ambeloe/iov-rp2040/iov-rp2040_top.png

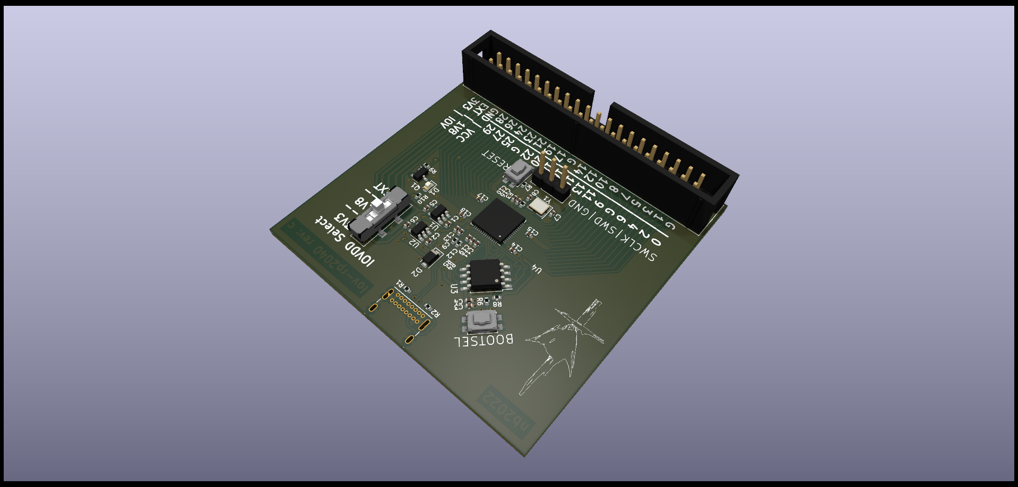
iov-rp2040_top.png
