ambeloe/iov-rp2040/README.md

# iov-rp2040
rp2040 dev board with selectable io voltages

iovdd range: 1.65v to 3.6v

PICO_FLASH_SPI_CLKDIV needs to be configured if running at 1.8V
generic boot2 needs to be used
