ambeloe/iov-rp2040/iov-rp2040.kicad_pcb

## KiCad design iov-rp2040.kicad_pcb (2022-09-12)

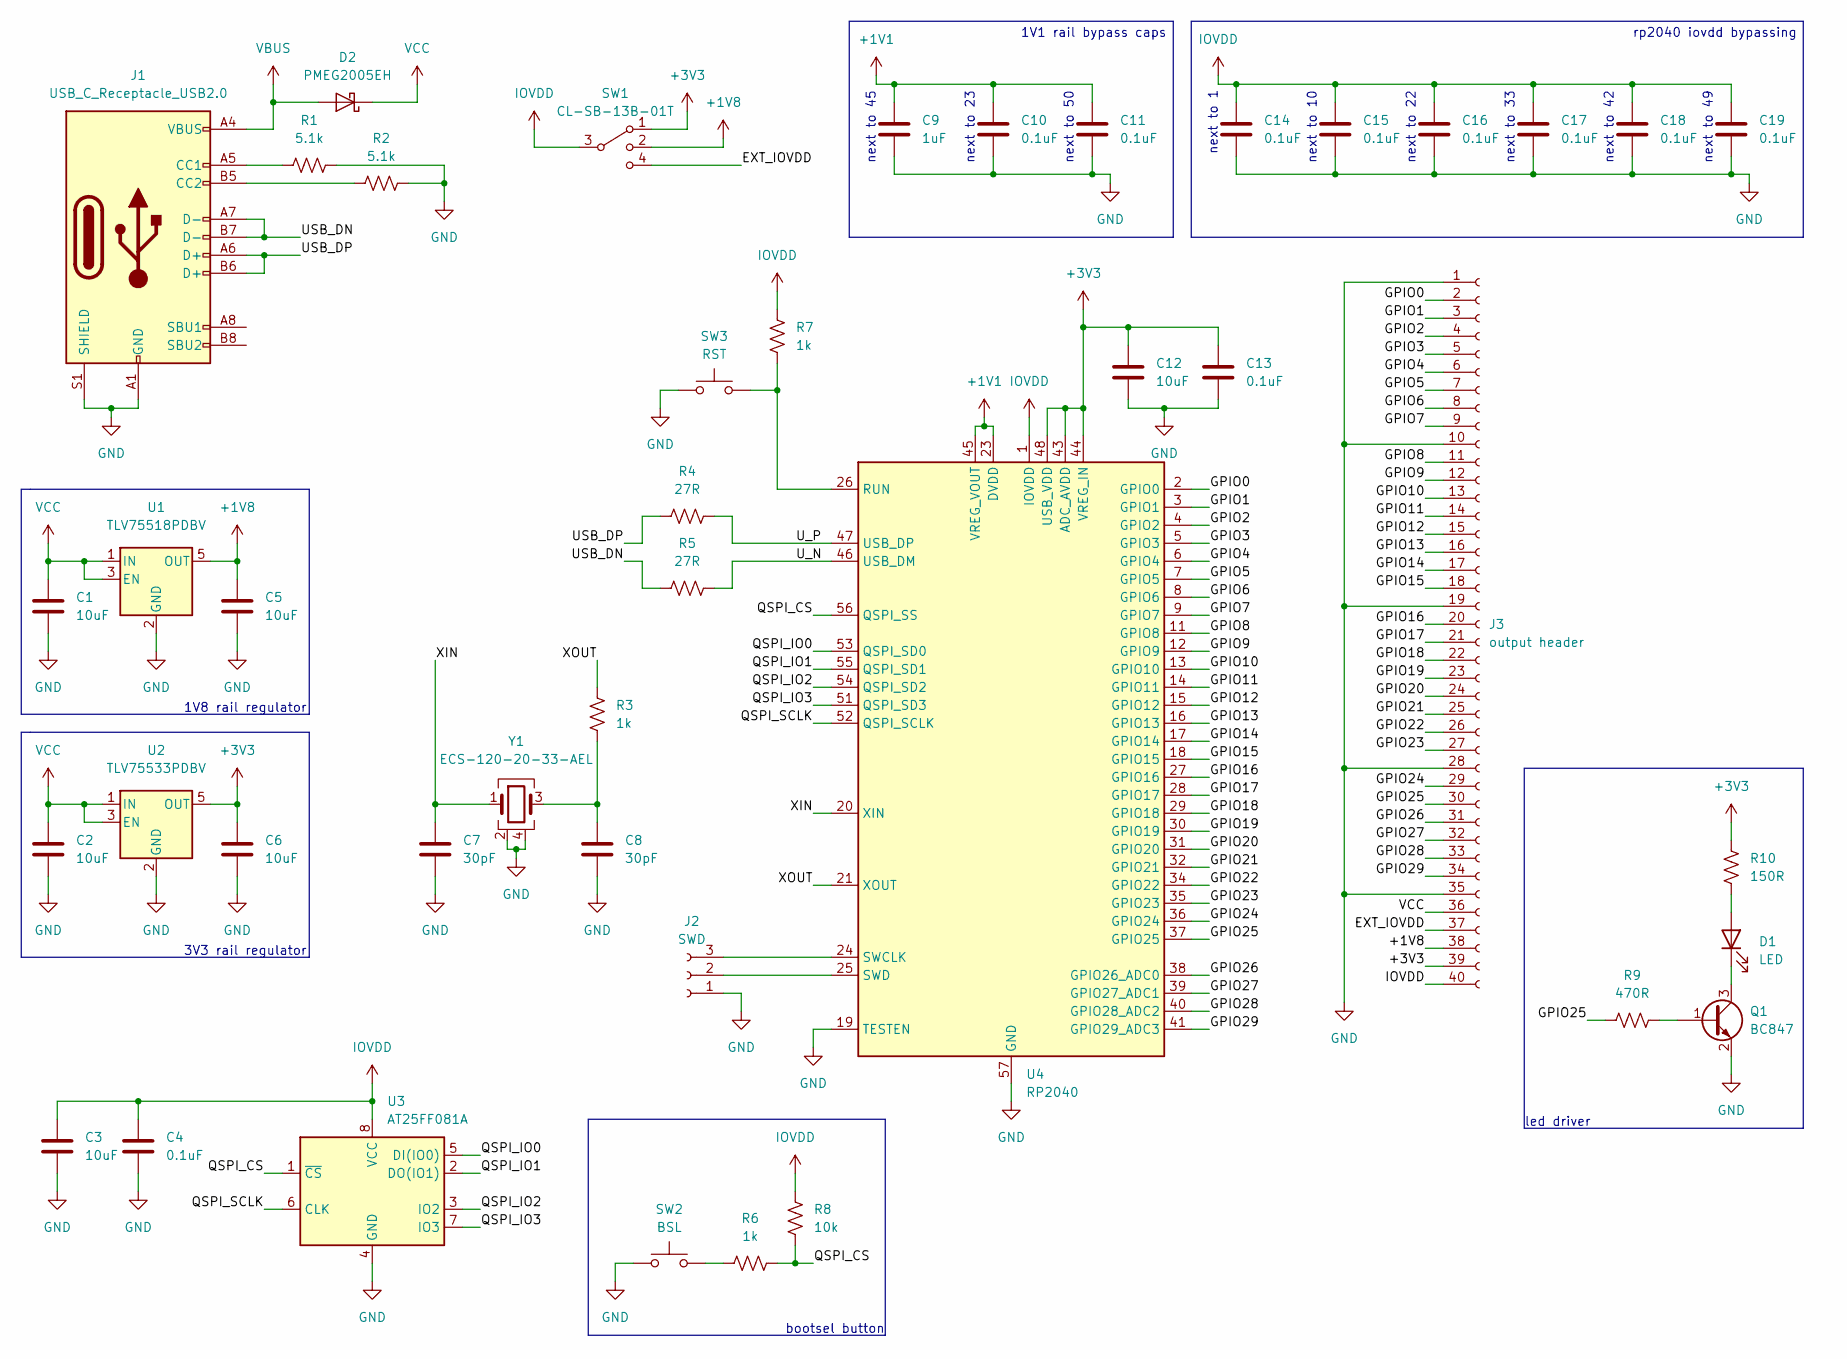
[picture p3: schematic iov-rp2040.kicad_sch]

Parts:
C1, C2, C3, C5, C6, C12: 10uF; C_0402_1005Metric_SmallRef
C4, C10, C11, C13, C14, C15, C16, C17, C18, C19: 0.1uF; C_0402_1005Metric_SmallRef
C7, C8: 30pF; C_0402_1005Metric_SmallRef
C9: 1uF; C_0402_1005Metric_SmallRef
D1: LED; LED_0603_1608Metric
D2: PMEG2005EH; D_SOD-123F
J1: USB_C_Receptacle_USB2.0; USB_C_Receptacle_GCT_USB4085
J2: SWD; PinHeader_1x03_P2.54mm_Vertical
J3: output header; IDC-Header_2x20_P2.54mm_Vertical
Q1: BC847; SOT-23
R1, R2: 5.1k; R_0402_1005Metric_SmallRef
R3, R6, R7: 1k; R_0402_1005Metric_SmallRef
R4, R5: 27R; R_0402_1005Metric_SmallRef
R8: 10k; R_0402_1005Metric_SmallRef
R9: 470R; R_0402_1005Metric_SmallRef
R10: 150R; R_0402_1005Metric_SmallRef
SW1: CL-SB-13B-01T
SW2: BSL; SW_SPST_EVQP2
SW3: RST; SW_SPST_EVQP2
U1: TLV75518PDBV; SOT-23-5
U2: TLV75533PDBV; SOT-23-5
U3: AT25FF081A; SOIC-8_5.275x5.275mm_P1.27mm
U4: RP2040; QFN-56-1EP_7x7mm_P0.4mm_EP3.2x3.2mm
Y1: ECS-120-20-33-AEL; Crystal_SMD_3225-4Pin_3.2x2.5mm

Connections:
+1V1: C9.1, C10.1, C11.1, U4.23 (DVDD), U4.45 (VREG_VOUT), U4.50 (DVDD)
+1V8: C5.1, J3.38, SW1.2, U1.5 (OUT)
+3V3: C6.1, C12.1, C13.1, J3.39, R10.2, SW1.1, U2.5 (OUT), U4.43 (ADC_AVDD), U4.44 (VREG_IN), U4.48 (USB_VDD)
/EXT_IOVDD: J3.37, SW1.4
/GPIO0: J3.2, U4.2 (GPIO0)
/GPIO1: J3.3, U4.3 (GPIO1)
/GPIO2: J3.4, U4.4 (GPIO2)
/GPIO3: J3.5, U4.5 (GPIO3)
/GPIO4: J3.6, U4.6 (GPIO4)
/GPIO5: J3.7, U4.7 (GPIO5)
/GPIO6: J3.8, U4.8 (GPIO6)
/GPIO7: J3.9, U4.9 (GPIO7)
/GPIO8: J3.11, U4.11 (GPIO8)
/GPIO9: J3.12, U4.12 (GPIO9)
/GPIO10: J3.13, U4.13 (GPIO10)
/GPIO11: J3.14, U4.14 (GPIO11)
/GPIO12: J3.15, U4.15 (GPIO12)
/GPIO13: J3.16, U4.16 (GPIO13)
/GPIO14: J3.17, U4.17 (GPIO14)
/GPIO15: J3.18, U4.18 (GPIO15)
/GPIO16: J3.20, U4.27 (GPIO16)
/GPIO17: J3.21, U4.28 (GPIO17)
/GPIO18: J3.22, U4.29 (GPIO18)
/GPIO19: J3.23, U4.30 (GPIO19)
/GPIO20: J3.24, U4.31 (GPIO20)
/GPIO21: J3.25, U4.32 (GPIO21)
/GPIO22: J3.26, U4.34 (GPIO22)
/GPIO23: J3.27, U4.35 (GPIO23)
/GPIO24: J3.29, U4.36 (GPIO24)
/GPIO25: J3.30, R9.1, U4.37 (GPIO25)
/GPIO26: J3.31, U4.38 (GPIO26_ADC0)
/GPIO27: J3.32, U4.39 (GPIO27_ADC1)
/GPIO28: J3.33, U4.40 (GPIO28_ADC2)
/GPIO29: J3.34, U4.41 (GPIO29_ADC3)
/QSPI_CS: R6.2, R8.2, U3.1 (~CS), U4.56 (QSPI_SS)
/QSPI_IO0: U3.5 (DI(IO0)), U4.53 (QSPI_SD0)
/QSPI_IO1: U3.2 (DO(IO1)), U4.55 (QSPI_SD1)
/QSPI_IO2: U3.3 (IO2), U4.54 (QSPI_SD2)
/QSPI_IO3: U3.7 (IO3), U4.51 (QSPI_SD3)
/QSPI_SCLK: U3.6 (CLK), U4.52 (QSPI_SCLK)
/USB_DN: J1.A7 (D-), J1.B7 (D-), R5.1
/USB_DP: J1.A6 (D+), J1.B6 (D+), R4.1
/U_N: R5.2, U4.46 (USB_DM)
/U_P: R4.2, U4.47 (USB_DP)
/XIN: C7.1, U4.20 (XIN), Y1.1
/XOUT: R3.1, U4.21 (XOUT)
GND: C1.2, C2.2, C3.2, C4.2, C5.2, C6.2, C7.2, C8.2, C9.2, C10.2, C11.2, C12.2, C13.2, C14.2, C15.2, C16.2, C17.2, C18.2, C19.2, J1.A1 (GND), J1.A12 (GND), J1.B1 (GND), J1.B12 (GND), J1.S1 (SHIELD), J2.1, J3.1, J3.10, J3.19, J3.28, J3.35, Q1.2 (E), R1.2, R2.2, SW2.1, SW3.1, U1.2 (GND), U2.2 (GND), U3.4 (GND), U4.19 (TESTEN), U4.57 (GND), Y1.2, Y1.4
IOVDD: C3.1, C4.1, C14.1, C15.1, C16.1, C17.1, C18.1, C19.1, J3.40, R7.1, R8.1, SW1.3, U3.8 (VCC), U4.1 (IOVDD), U4.10 (IOVDD), U4.22 (IOVDD), U4.33 (IOVDD), U4.42 (IOVDD), U4.49 (IOVDD)
unnamed: C8.1, R3.2, Y1.3
unnamed: D1.1 (K), Q1.3 (C)
unnamed: D1.2 (A), R10.1
unnamed: J1.A5 (CC1), R1.1
unnamed: J1.B5 (CC2), R2.1
unnamed: J2.2, U4.25 (SWD)
unnamed: J2.3, U4.24 (SWCLK)
unnamed: Q1.1 (B), R9.2
unnamed: R6.1, SW2.2
unnamed: R7.2, SW3.2, U4.26 (RUN)
VBUS: D2.2 (A), J1.A4 (VBUS), J1.A9 (VBUS), J1.B4 (VBUS), J1.B9 (VBUS)
VCC: C1.1, C2.1, D2.1 (K), J3.36, U1.1 (IN), U1.3 (EN), U2.1 (IN), U2.3 (EN)

Notes on the sheet:
bootsel button
1V1 rail bypass caps
1V8 rail regulator
led driver
next to 10
next to 42
next to 1
next to 49
next to 45
next to 23
rp2040 iovdd bypassing
next to 22
next to 50
next to 33
3V3 rail regulator

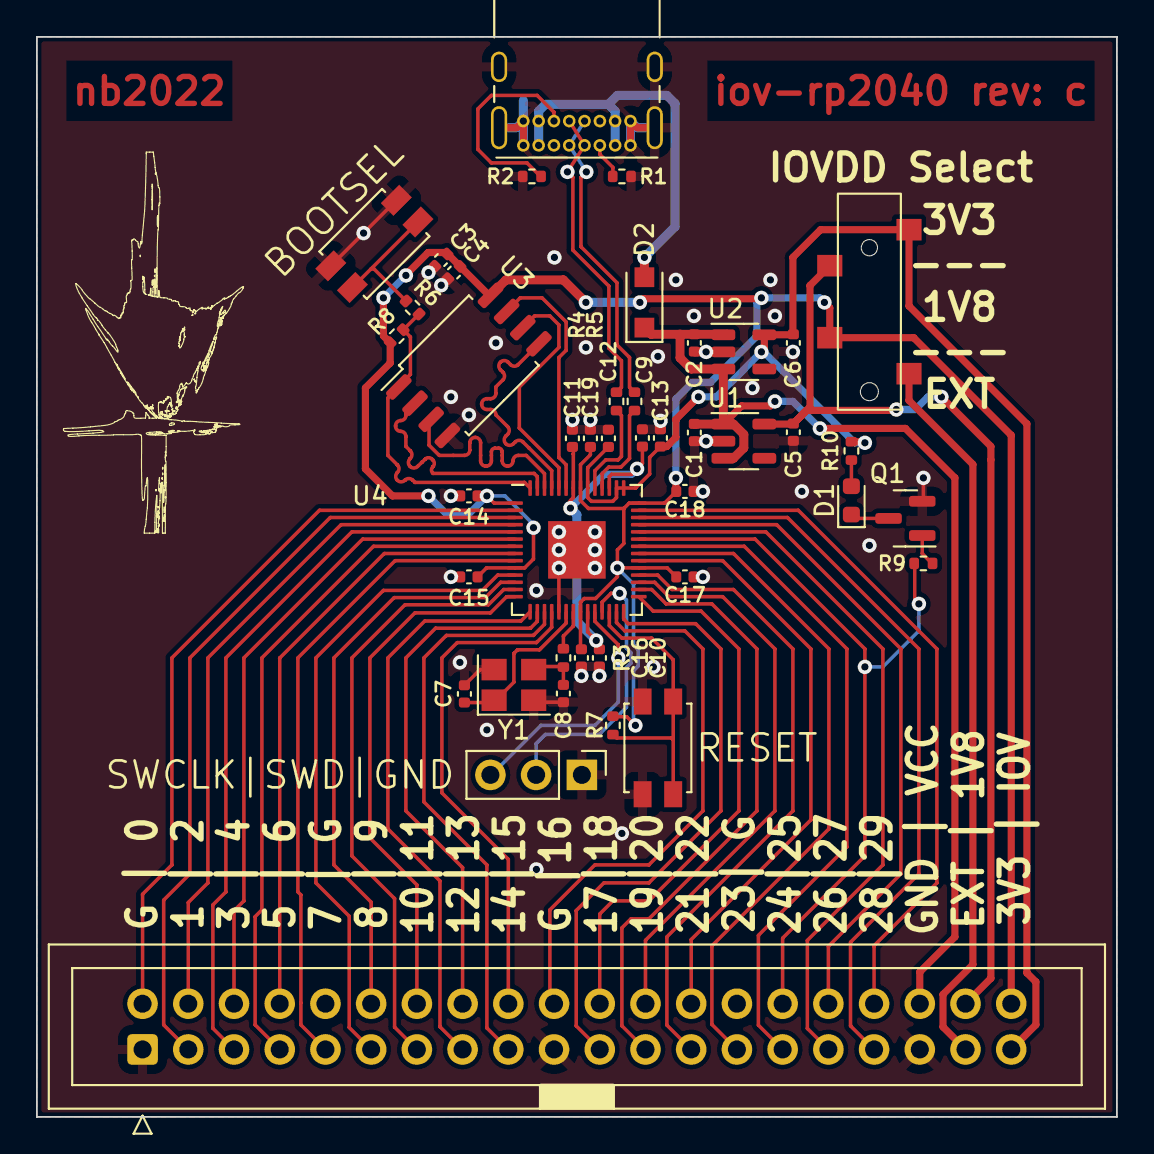
[picture p4: board iov-rp2040.kicad_pcb from above]

Board: 2 copper layers, 60.0 x 60.0 mm, 43 parts (0 on the bottom side), 60 nets.
