ambeloe/iov-rp2040/(commit log)

2022-08-28 initial commti
    [iov-rp2040-B_Cu.gbl, iov-rp2040-B_Cu.gbr, iov-rp2040-B_Mask.gbr, iov-rp2040-B_Mask.gbs, iov-rp2040-B_Paste.gbp, iov-rp2040-B_Paste.gbr, iov-rp2040-B_Silkscreen.gbo, iov-rp2040-B_Silkscreen.gbr]
2022-08-28 fix gitignore
    [iov-rp2040-B_Cu.gbl, iov-rp2040-B_Cu.gbr, iov-rp2040-B_Mask.gbr, iov-rp2040-B_Mask.gbs, iov-rp2040-B_Paste.gbp, iov-rp2040-B_Paste.gbr, iov-rp2040-B_Silkscreen.gbo, iov-rp2040-B_Silkscreen.gbr]
2022-09-06 revision b:
    fixed flash footprint
    changed ground pour to be cleaner
    added name and revision text
    [iov-rp2040.kicad_pcb, iov-rp2040.kicad_sch]
2022-09-06 updated bom for rev b
2022-09-12 length matched qspi and redid power section
    [iov-rp2040.kicad_pcb]
